KisonHe/HoloCube-PCB/checks.md

| checks | |
| --- | ---- |
| Screen | Pass |
| LIS2DH12TR | Pass |
| BH1750FVI  | Pass |
| WS2812 | Pass |
| WiFi | Works; C8 10pF, C7&C9 NC, RSSI ~= -75; C8 10pF, C7&C9 = GND, RSSI ~= -60; C8 10pF, C7&C9 = 100nf, RSSI ~= -60; For Compare ESP32-WROOM-32D RSSI is -35|
| SDCard | Pass |
| Buttons | Pass |
