KisonHe/HoloCube-PCB/ScreenBoard/ScreenBoard.kicad_pcb

## KiCad design ScreenBoard/ScreenBoard.kicad_pcb (2022-06-17)

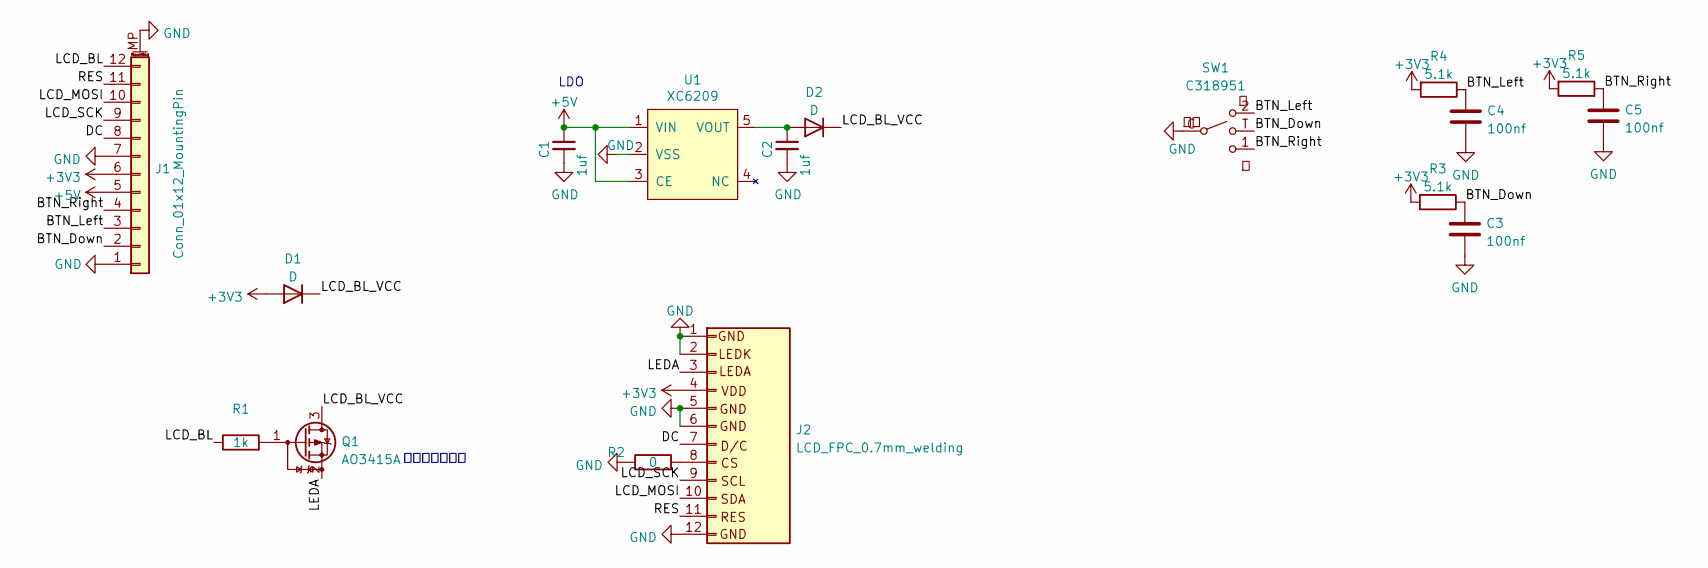
[picture p1: schematic ScreenBoard.kicad_sch]

Parts:
C1, C2: 1uf; C_0402_1005Metric
C3, C4, C5: 100nf; C_0402_1005Metric
D1, D2: D; R_0603_1608Metric
J1: Conn_01x12_MountingPin; Hirose_FH12-12S-0.5SH_1x12-1MP_P0.50mm_Horizontal
J2: LCD_FPC_0.7mm_welding; FPC_welding_0.7mm_P0.4mm
Q1: AO3415A; SOT-23
R1: 1k; R_0402_1005Metric
R2: 0; R_0402_1005Metric
R3, R4, R5: 5.1k; C_0402_1005Metric
SW1: C318951
U1: XC6209; SOT-23-5

Connections:
+3V3: D1.2 (A), J1.6, J2.4, R3.2, R4.2, R5.2
+5V: C1.1, J1.5, U1.1 (VIN), U1.3 (CE)
/BTN_Down: C3.1, J1.2, R3.1, SW1.T
/BTN_Left: C4.1, J1.3, R4.1, SW1.2
/BTN_Right: C5.1, J1.4, R5.1, SW1.1
/DC: J1.8, J2.7
/LCD_BL: J1.12, R1.1
/LCD_BL_VCC: D1.1 (K), D2.1 (K), Q1.3 (D)
/LCD_MOSI: J1.10, J2.10
/LCD_SCK: J1.9, J2.9
/LEDA: J2.3, Q1.2 (S)
/RES: J1.11, J2.11
GND: C1.2, C2.2, C3.2, C4.2, C5.2, J1.1, J1.7, J1.MP (MountPin), J2.1, J2.2, J2.5, J2.6, J2.12, R2.1, SW1.C, U1.2 (VSS)
unnamed: C2.1, D2.2 (A), U1.5 (VOUT)
unnamed: J2.8, R2.2
unnamed: Q1.1 (G), R1.2

Notes on the sheet:
封装不对，小了
LDO

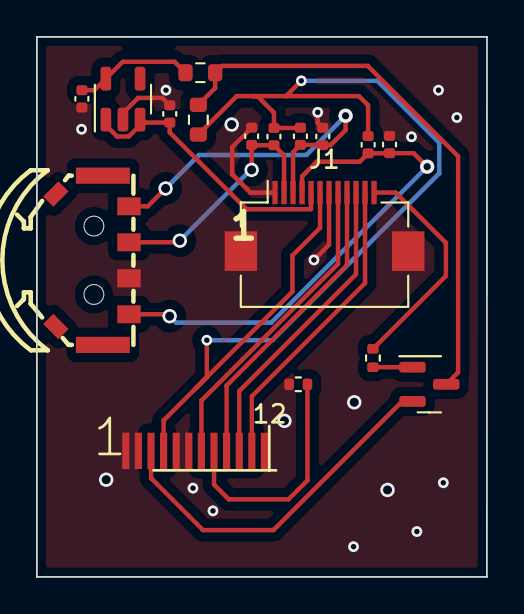
[picture p2: board ScreenBoard.kicad_pcb from above]

Board: 2 copper layers, 25.0 x 30.0 mm, 17 parts (0 on the bottom side), 16 nets.
