KisonHe/HoloCube-PCB/(commit log)

2022-05-07 Init Repo
    [HoloCube.kicad_pcb, HoloCube.kicad_sch]
2022-05-07 Place Parts
    [HoloCube.kicad_pcb, HoloCube.kicad_sch]
2022-05-07 Random Version 0.0
    [HoloCube.kicad_pcb, HoloCube.kicad_sch]
2022-05-08 Improve According to t123yh
    [HoloCube.kicad_pcb, HoloCube.kicad_sch]
2022-05-08 Improve again
    [HoloCube.kicad_pcb, HoloCube.kicad_sch]
2022-05-08 V0.1 FinalVer
    [HoloCube.kicad_pcb]
2022-05-13 Fix Error
    [ScreenBoard.kicad_pcb, ScreenBoard.kicad_sch]
2022-05-13 只用三轴还是不方便输入，考虑增加波轮
    [HoloCube.kicad_pcb, HoloCube.kicad_sch]
2022-05-15 Fix Error & add SW
    [HoloCube.kicad_pcb, HoloCube.kicad_sch, ScreenBoard.kicad_pcb, ScreenBoard.kicad_sch]
2022-05-15 投板版本
    [HoloCube.kicad_pcb, HoloCube.kicad_sch]
2022-05-15 修正开窗问题
    [ScreenBoard.kicad_pcb]
2022-06-14 新款拨轮
    [ScreenBoard.kicad_pcb, ScreenBoard.kicad_sch]
2022-06-17 Fix most 3D parts
    [HoloCube.kicad_pcb, HoloCube.kicad_sch, ScreenBoard.kicad_pcb, ScreenBoard.kicad_sch]
